ToxSox/aes17_filter/hardware/README.md

# AES17 filter board: files and how to order

The passive class-D measurement filter from [docs/design-review.md](../docs/design-review.md),
as a board. Everything here is generated from `design.py`; nothing was drawn by hand, so a
changed value or part is a changed line and a re-run.

| File | What it is |
|---|---|
| `design.py` | every part with value, footprint, LCSC number and note; every net |
| `make_pcb.py` | places and routes the board with KiCad 7's `pcbnew` module, fills the ground planes, runs the DRC; writes `aes17-filter.kicad_pcb` |
| `export.py` | writes `fab/`: the Gerber + drill zip, the JLCPCB bill of materials and placement file, a parts list with notes |
| `make_schematic.py` | draws `aes17-filter-schematic.svg/.png` (schemdraw) |
| `make_frontwall.py` | draws the front wall's drilling and the panel legend, `aes17-filter-frontwall.svg/.png` |
| `check_release.py` | checks that the board, the order files, the source hash and the DRC report belong together; exit code 0 = fit to order |
| `aes17-filter.kicad_pcb` | the board, for KiCad 7 or newer; there is no `.kicad_sch`, the schematic is the drawing |
| `fab/aes17-filter-gerbers.zip` | upload this to JLCPCB |
| `fab/aes17-filter-bom.csv` | upload this as the BOM (Comment, Designator, Footprint, LCSC Part #) |
| `fab/aes17-filter-cpl.csv` | upload this as the placement file (Designator, Mid X, Mid Y, Layer, Rotation) |
| `fab/aes17-filter-parts.csv` | the same parts with values and notes, for ordering anything elsewhere |
| `fab/aes17-filter-schematic.pdf`, `fab/aes17-filter-drc.txt` | the schematic and the DRC report of this release |
| `fab/RELEASE.txt` | title, revision, the source hash printed on the board, and the SHA-256 of every order file |

top side

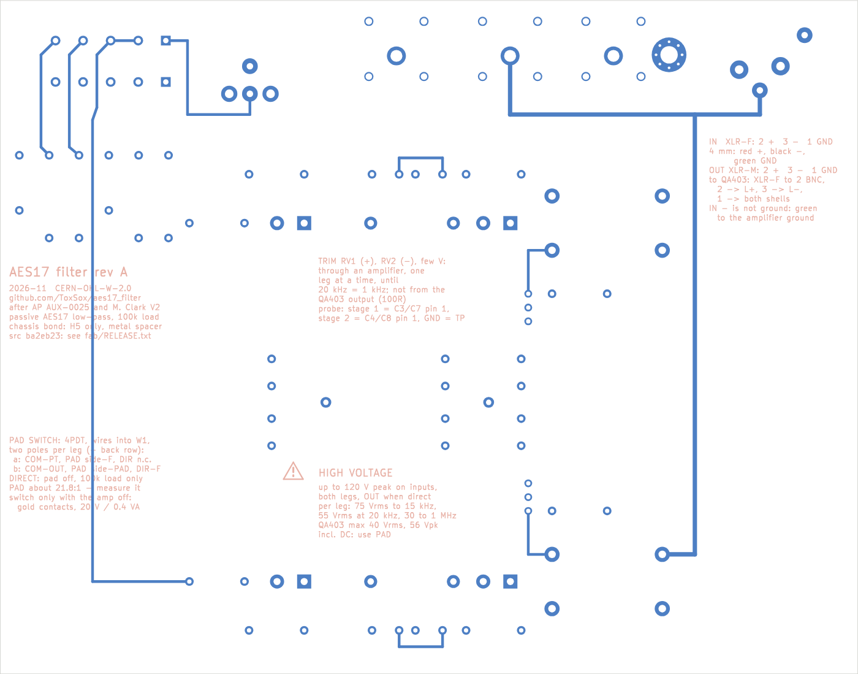
[picture p2: hardware/aes17-filter-bottom.png]
bottom side, seen from below: the crib sheet


## The board

158 × 124 mm, four layers, 1.6 mm, in a **Hammond 1444-862** aluminium chassis (203 × 152 × 51 mm,
flat 1 mm walls, closed by the 1434-86 bottom plate). **Every connector is on the front long
edge** and comes through the chassis' front long wall, so the filter hangs with that wall towards
the operator, as the AUX-0025's front panel does. From the left, seen from the front: the female
XLR input (pin 2 +, pin 3 −, pin 1 and shell ground), red and black 4 mm sockets at AP's
19.05 mm for a dual banana plug, the green common, the male XLR output (pin 2 +, pin 3 −), and
the pad toggle, mounted high in the wall straight above the switch. The QA403 is fed through a
self-made lead, XLR female to two BNC males. The first 24 mm behind the front edge are the
connector strip with the switch and the pad block at its right-hand end; the filter is the
100 mm band behind it, the two legs mirror images about its centre line. Layers 2 and 3 are
whole ground planes, broken only by the holes; every track is on layer 1 or 4. The board stands
on seven M3 spacers on the bottom plate (four on the centre line, H5 in the connector strip,
H6 and H7 in the back corners); the XLRs are screwed to the wall, the Cliff sockets held
by the board alone (they have no panel retention; the wall just has a clearance hole for the
Ø11 barrel). The DRC in KiCad 7 reports no errors and no unconnected nets at 0.8 mm clearance;
the warnings are silkscreen over pads and the footprints not being from a library table.

### Layout rules it follows

The board was gone over once more with the usual rules for audio layout. What they changed:

- **Whole ground planes.** Layers 2 and 3 carry nothing but ground. The earlier layout ran the
  two filter outputs on layer 3, which cut slots into the plane right under the output tracks
  on layer 4; those tracks lost their return path exactly where the analyzer's signal ran.
- **Clearance for the voltage.** Everything from the input up to OUT (in the direct position)
  carries the amplifier's voltage: laid out for 120 V peak (85 Vrms per leg, above the 75 Vrms rating). IPC-2221B asks 0.8 mm
  between bare pads at 101-300 V; the board had 0.3 mm and now keeps 0.8 mm everywhere. The
  male XLR's lands on pins 1 and 2 are 3.0 mm instead of Neutrik's 3.4 mm for the same reason.
- **The pad and the switch at the output connector.** The two pads now stand side by side right
  behind the switch, identical copies, so they share a temperature and their ratios track. The
  4PDT toggle sits in the wall straight above W1, ten solder holes, and its wires drop about
  15 mm into them; before, they ran 75 mm through the box to a header in the middle of the
  board. W1's holes run in the order the nets leave the pad block (OUT, F, F, PT, PAD), the +
  leg's row on top and the − leg's on the bottom, so no track crosses another; the − leg's tracks
  come down between the + row's holes, 5.08 mm apart for exactly that.
- **Long runs only at low impedance.** The negative leg ends at the back of the board, so one
  track has to come forward. It is now the filter output F_N, behind 24.9 Ω, the lowest
  impedance in the chain, and it runs alone through empty board. Before, the output pair came
  back to the middle of the board, and in the pad position OUT sits behind 950 Ω, where 1 pF of
  stray capacitance from the input side is already −50 dB at 500 kHz.
- **Pairs kept together.** IN+ and IN− run on top of each other (layer 1 over layer 4) from the
  connectors to where the legs part; OUT+ and OUT− run side by side, 1 mm apart, from W1 to the
  XLR. Before, the negative input went round the board's left edge and the two outputs ran 10 mm
  apart.
- **More distance between the stages.** The second coil of each leg is 38 mm from the first
  instead of 32 mm. Coupling between two drum cores falls with the cube of the distance, so
  L1 → L2, the one path that bypasses the filter, is about 4.5 dB weaker.
- **One chassis bond, where the cables come in.** H5 is a plated hole on ground in the
  connector strip, next to the input XLR: with a metal spacer it ties the ground plane to the
  bottom plate and so to the chassis, and cable shield currents go to the chassis there instead
  of crossing the filter. The other six holes are plain.

What stayed as it was, because it was right: the two legs mirror images, so each sees the same
parasitics; the shunt capacitors' grounds meeting in the middle of the board, so the
differential residue current takes a short path between the legs; polypropylene capacitors and
metal-film resistors throughout; the hot 3 W input resistors well away from the polypropylene
capacitors (FKP2 is rated to 100 °C).

### Silkscreen

Top: every part with its name and value in the notation that survives a lost dot (R1 1k 3W,
R7 24R9, C3 4n7, L1 1mH), the pad block with a legend under each pad, each leg's signal flow
along its outer edge (input network, stage 1, stage 2, pad), a high-voltage warning beside the
inputs, W1's ten holes labelled for the toggle wires (+OUT, +F, +F, +PT, +PAD and the same with −), and the title
"AES17 filter rev A" with date, licence and source location (the CERN-OHL-W asks for the source
location on the product where practicable). Bottom, readable from below: a crib sheet with the
connector pin-outs and the QA403 lead, the switch wiring, the trim procedure and
the voltage limits. Both sides carry "src" and the source hash, the first seven digits of the
SHA-256 of `design.py` and `make_pcb.py`, the same as in `fab/RELEASE.txt`. Two ground loops,
TP1 and TP2, sit between the stages for a scope probe's ground spring. Title, revision and date
are three constants at the top of `design.py`.

## Ordering at JLCPCB

0. **Check the release.** `python3 hardware/check_release.py` must end with "fit to order".
   Order from a commit, not from a working copy, and keep its source hash (in `fab/RELEASE.txt`
   and printed on both sides of the board, "src ...") with the order: a board in the hand is
   then matched to its files without guessing.
1. **PCB.** Upload `fab/aes17-filter-gerbers.zip`. Four layers, 1.6 mm, any colour, 1 oz copper,
   HASL or ENIG as you like, five pieces (the minimum). The stack-up JLCPCB offers for four
   layers (JLC04161H-7628 or similar) is fine; nothing here depends on impedance.
2. **Assembly.** Tick assembly, **five boards** (all of them: two for this bench, two for a
   colleague's, one spare; JLCPCB's minimum is two), top side only, Economic. Upload
   `fab/aes17-filter-bom.csv` and `fab/aes17-filter-cpl.csv`. All parts are through-hole;
   JLCPCB hand-solders those ($3.58 per order plus $0.0164 per joint, one extra day).
3. **Parts review.** In the parts page every line with an LCSC number resolves on its own,
   because the files hold only parts JLCPCB had in stock. **Left out, to be bought locally and
   soldered by hand:** the coils L1-L4 (Würth 7687480102, Digi-Key; at JLCPCB only the
   7447480102, C1331132, on pre-order), the 412 Ω R4/R14, the Cliff sockets J1-J3 and the film
   capacitors C1-C10. The shielded
   WE-TIS 7447471102, C1331105, fits the same footprint; it was the coil of the first draw of
   rev A and is now only the comparison for the linearity test (JLCPCB lists it as ±20 %, which
   the trimmer cannot always reach). The 412 Ω 0.6 W had three pieces in stock at JLCPCB
   (C1235858) on 2 November 2026; any 412 Ω 1 % 0.6 W in a 0207 body does. The
   BOM file is plain ASCII on purpose: JLCPCB's import reads "Würth" as "W眉rth". The ten WIMA film capacitors (C1-C10) are **not in the BOM and the placement file**: JLCPCB has them only on pre-order (19-21 working days, quoted on 3 November 2026), so they are bought locally and soldered by hand. The Cliff sockets would be **pre-order** too: JLCPCB
   buys them after payment, quotes the final price within 48 hours, and they take nine to
   twenty business days to arrive; connectors carry a $20 inspection fee per type, so the three
   Cliff colours cost $60 in inspection alone. So they are **left out of the assembly** (they
   are not in the files), bought at Digi-Key (6.80 € each against $11-12 pre-order) and solder the three per board yourself - one
   pin and four pegs each.
4. **Every line has an LCSC number.** The pad's upper arms (R8, R9, R18, R19) are TE YR1B10KCC,
   10.0 kΩ 0.1 % 15 ppm, C1364313 (2 397 in stock on 2 November 2026), the same family as the
   1.00 kΩ lower arm; a 0207 body on the 15.24 mm pitch. R6/R16 are the Vishay MRS25 3.40 kΩ
   0.6 W, C1366835 (125 in stock).
5. **W1 is not a part.** It is ten plated holes for the toggle's wires and is not in the BOM or
   the placement file; the 4PDT toggle is bought separately (RS, Mouser) and wired by hand.
6. After the order: the five boards arrive assembled. Nothing else is needed from JLCPCB.

### What JLCPCB's BOM tool quoted on 1 November 2026

For an assembly of five boards (quantities include JLCPCB's attrition allowance), in euros:

| Line | Qty | Total | Per piece | Status |
|---|---|---|---|---|
| TE 5227161-7 BNC (C591726) | 20 | 99.63 | 4.98 | in stock; no longer on the board - the XLR output replaced the BNCs |
| Cliff FCR7350R / B / G (C6041087 / C6555263 / C6041085) | 5 each | 58.13 / 58.13 / 50.32 | 11.6 / 11.6 / 10.1 | **shortage: pre-order**, plus the connector inspection fee per type |
| WIMA 220 pF 630 V ±2.5 % (C5742108) | 30 | 7.19 | 0.24 | shortage: pre-order, 19 working days; now soldered by hand instead |
| WIMA 4.7 nF 250 V (C20412818) | 25 | 10.70 | 0.43 | shortage: pre-order, 21 working days; now soldered by hand instead |
| Bourns 3296W-1-501LF (C69564) | 10 | 6.75 | 0.67 | in stock |
| TE YR1B1K0CC 0.1 % (C1364308) | 10 | 3.57 | 0.36 | in stock |
| UNI-ROYAL 1 kΩ 3 W (C58750) | 21 | 1.04 | 0.05 | in stock |
| UNI-ROYAL 10 kΩ 1 W (C58714) | 21 | 0.51 | 0.02 | in stock; replaced by TE YR1B10KCC 0.1 % (C1364313, about 0.50 € each) |
| 75 Ω 1 W (C160685) | 11 | 0.47 | 0.04 | in stock |
| 14 k, 412, 3.4 k, 24.9 (C127223, C3558411, C3517441, C3542579) | 11-15 each | 0.15 / 0.06 / 0.17 / 0.36 | 0.01-0.02 | in stock; the 412 and 3.4 k are now 0.6 W Vishay MRS25 (C1235858, C1366835), not yet quoted |
| Würth 7447471102 coils | 20 | about 58 | 2.9 | "Vorbestellen" → global sourcing; replaced by the unshielded 7447480102 (C1331132, 2.14 €) |

About 356 € of parts for five assembled boards, 71 € per board, of which the three Cliff sockets
are 33 € and the four BNCs 20 € (the BNCs have since left the board). The Cliff sockets are the line to take out of the assembly:
pre-order at 11 € each plus the inspection fee, against 6.80 € at Digi-Key for a part with one
pin and four pegs to solder. That quote still holds the BNCs, the Cliff sockets, the film
capacitors and the coils, none of which is in the JLCPCB files any more; what JLCPCB fits now is
the resistors, the trimmers and the two XLRs, so the parts bill it shows at ordering is well
below it. The stock of all ten lines covered five boards on 3 November 2026; the tightest were
C58750 (1 kΩ 3 W, 153 for 20) and C1366835 (3.40 kΩ, 125 for 10).

## Shopping list, bought locally (five boards)

JLCPCB fits the 22 parts per board it had in stock. Everything else is bought locally; the
quantities are for all five boards and include what pairing the legs needs (see "Building the
boards", step 1). Pair from **one pool for all five**: any matched pair can go on any board.
**Why 24 of a ±5 % part for 20 places:** ten pairs within 1 % are wanted; the chance of finding
them is 21 % from 20 parts, 93 % from 22 and 100 % from 24 if the values spread evenly over the
tolerance, and 42 / 98 / 100 % for a typical reel, whose spread is narrower (simulated,
tolerance = 3σ). Two more cover a bent lead and give the winding-sense test its sender coil.
For a single board it would be 8 for 4 places (98 %), for two boards 12 for 8: the bigger the
pool, the smaller the surplus per board.

**On the board, soldered by hand:**

| Buy | Fitted | Part | Pairing | Where |
|---|---|---|---|---|
| 26 | 20 | **Würth 7687480102**, 1 mH ±5 %, unshielded drum core (L1-L4) | ten pairs, L1/L3 and L2/L4 per board, from 24 | Digi-Key |
| 26 | 20 | **WIMA FKP2F014701I00JA00**, 4.7 nF 250 V ±5 % (C3, C4, C7, C8) | ten pairs, C3/C7 and C4/C8 per board, from 24 | Digi-Key |
| 33 | 30 | **WIMA FKP2J002201D00ESSD**, 220 pF 630 V **±1 %** (C1, C2, C5, C6, C9, C10) | two ±1 % parts differ by 2 % at most, which is what the simulation counts as paired; measure and sort anyway: the closest two as C1/C5, then C2 + C9 against C6 + C10 | Bürklin 42D8516 |
| (40) | (30) | or the ±2.5 % FKP2J002201D00HSSD, if the ±1 % is not to be had | then pairing matters: 40 to choose from | Digi-Key, Bürklin |
| 12 | 10 | **412 Ω 1 % 0.6 W**, Vishay MRS25000C4120FCT00 or any 0207 body (R4, R14) | none needed | Digi-Key, Mouser, Bürklin |
| 5 each | 5 each | **Cliff FCR7350R, FCR7350B, FCR7350G**, red, black, green (J1-J3) | - | Digi-Key, Farnell |

**For pairing and the verification tests, not on the board** (one set does all five boards, if
one person pairs, trims and tests them; that is also how all five come out alike):

| Buy | Part | For |
|---|---|---|
| 1 each | 100 Ω, 6.8 kΩ, 47 kΩ, 1 %, 0.25 W | the series resistor when pairing with the QA403: coils, 4.7 nF, 220 pF |
| 2 + 1 | 10 kΩ and 1 kΩ, 1 %, **3 W or more**, metal film (the UNI-ROYAL MFR03S on the board, or a Vishay PR03) | test 4's reference divider, 2 × 10 k over 1 k as the pad: at 75 Vrms it runs at about 4 % of its rating, so it adds no self-heating distortion of its own |
| 1 | 1 Ω, 1 % | test 5's current shunt in the green lead |
| 4, optional | Würth WE-TIS 7447471102, shielded | test 4's comparison, one board's worth (availability outside JLCPCB not checked) |

Plus the box, the toggle and the leads in the next table.

## What is not on the board

| Qty for five boards | Part | Where |
|---|---|---|
| 20 | screws for the XLR flanges: M3 × 8 and nuts if the flange holes are through-holes, else 2.9 mm self-tapping (Neutrik's drawing of the NC3FAAH2 / NC3MAAH decides; not checked) | any |
| 2 | a cable from the amplifier's terminals to a male XLR plug (pin 2 +, pin 3 −), or dual banana leads - the same cable then feeds an AUX-0025; one per bench | self-made |
| 2 | an XLR-female-to-two-BNC-male lead to the QA403: pin 2 to L+ centre, pin 3 to L− centre, pin 1 to both BNC shells; about 30 cm, both legs equal; one per bench | self-made (Neutrik NC3FXX, two BNC plugs, two pieces of RG58 or RG174) |
| 5 | **4PDT** toggle, ON-ON, non-shorting, **gold contacts**, panel mount, 1/4 in bushing, solder lugs; best with a locking lever | APEM 5666CDB or another 4PDT with gold contacts; the switch carries microamperes at 100 kΩ, a dry circuit, so standard silver contacts (a plain Knitter MTA 206, for one) are not suitable. Gold contacts are rated to switch only 0.4 VA at 20 V: they carry the full voltage closed, but are switched with the amplifier off |
| 5 | insulating sheet, 0.25 mm polyester or fish paper, cut to the bottom plate around the spacers | any |
| 5 | Hammond 1444-862 chassis and 1434-86 bottom plate | Digi-Key, Mouser, Reichelt; about 20 € and 11 € |
| 35 | M3 spacers, 10 mm, and M3 screws, for the board on the bottom plate (seven per board); the one under H5 metal, with a star washer on the bottom plate | any |
| | wire for the toggle: ten pieces per board of about 25 mm, 0.25 mm² stranded, into W1's holes | |

## Building the boards

1. Check the assembled board against `fab/aes17-filter-parts.csv`.
   Then solder what JLCPCB leaves out, per board: the 412 Ω 0.6 W in R4 and R14; the coils,
   L1/L2 (+ leg) and L3/L4 (− leg), all four with the same winding sense (see below); 220 pF in C1, C2, C9 (+) and C5, C6, C10 (−),
   4.7 nF in C3, C4 (+) and C7, C8 (−); and the Cliff sockets, red J1, black J2, green J3. Before
   soldering, **measure coils and capacitors and give the two legs the closest pairs** (L1/L3,
   L2/L4, C1/C5, C2+C9 / C6+C10, C3/C7, C4/C8); the polypropylene parts have no polarity. For
   the frequency response the trimmer takes care of the spread, but not for the legs' phase:
   pairing **both** coils and capacitors to 1 % moves the common mode in the difference from
   −31 to −45 dB at 20 kHz and from −14 to −29 dB at 100 kHz (simulation, 95 % of boards);
   pairing only one of the two gains 2-4 dB, because the other still sets the phase.

   **Pairing without an LCR meter**, with the QA403: its output through a series resistor
   into the part, the part's other end to ground; the left input across the part, the right
   input on the output. Sweep once to find where the left reads 3 dB below the right, then
   read every part of that value at that frequency: 1 % in value is about 0.04 dB there. The
   resistor sets the frequency: 6.8 kΩ for the 4.7 nF (about 5 kHz), 47 kΩ for the 220 pF
   (about 10 kHz with the lead's capacitance), 100 Ω for the 1 mH coils (about 16 kHz). Keep
   the leads and the part's position the same for every part of one value; only the
   differences count.

   **Winding sense of the coils.** For the filter either way round works, but an unshielded
   drum core picks up stray magnetic fields (a mains transformer, a load bank), and the
   aluminium box does not screen 50 Hz. A field that reaches both legs alike then appears as
   common mode, which the QA403 rejects, only if L1 and L3 (and L2 and L4) are the same way
   round; Würth does not mark the start of the winding. To find it with the QA403 before
   soldering: QA403 output, 1 kHz at about 1 V, into one coil (the "sender") through 100 Ω;
   stand each other coil on top of it, axis on axis and always leads up, its leads to the left
   input, and read the phase against the output: about +90° or −90° (the induced voltage leads
   the current). Mark the lead that gives +90° on the left input's centre pin and put it in the
   square pad on all four. Then test the sender itself the same way, with a marked coil as
   the sender.
2. Drill the front wall after `aes17-filter-frontwall.png`; the hole table is at the end of this
   file. Easiest and safest: drill the seven spacer holes in the bottom plate, stand the board on
   its spacers, put the chassis over it, and mark the connector centres through from inside.
3. Fit the board on the bottom plate, put the chassis over it, screw the XLR flanges to the
   wall, fit the toggle.
4. Wire the 4PDT toggle into W1, straight below it, by the silkscreen labels: two poles per
   leg, the + leg to the back row, the − leg to the front row. Decide which lever position is
   PAD and call the throw lugs on that side "PAD side", the others "DIR side"; then per leg
   - pole a: common → PT, PAD side → F, DIR side not connected
   - pole b: common → OUT, PAD side → PAD, DIR side → the other F
   Check with an ohmmeter between the output XLR's pin 2 (then pin 3) and pin 1, inputs open:
   about 1.0 kΩ in PAD (the pad's 1 kΩ leg), open in DIRECT (the pad is off). And from the red
   (then black) input to the green: about 21 kΩ in PAD, open in DIRECT. Mark the positions on the
   front.
5. Lay the insulating sheet on the bottom plate before the board goes in; use a metal spacer
   under H5 and plastic or metal under the rest (only H5 is plated). Set the trimmers (step 6)
   with a few volts from the amplifier: the trim does not depend on the level, and the box is
   open while you turn them.
6. Work through the [verification plan](../docs/design-review.md#verification-what-makes-it-a-reference):
   trim both legs through an amplifier until 20 kHz equals 1 kHz, the pad ratio over frequency
   into the measurement software's probe settings, then the ferrite, ground, heat and stop-band tests before the
   filter is used as a reference. Connect the green socket to the amplifier's ground in use.

## Regenerating

```
python3 hardware/make_pcb.py        # board + DRC report (needs KiCad 7 with pcbnew for Python)
python3 hardware/make_schematic.py  # schematic, also fab/…-schematic.pdf (pip install schemdraw)
python3 hardware/export.py          # fab/ and fab/RELEASE.txt (needs kicad-cli; after the schematic)
python3 hardware/make_frontwall.py  # front wall drilling (matplotlib)
python3 hardware/check_release.py   # do the files belong together?
```

Run `make_schematic.py` before `export.py`: the schematic PDF is one of the files the release
manifest hashes.

## Front wall holes

See `aes17-filter-frontwall.png`; the table below is printed by `make_frontwall.py`. In blue the
drawing also carries the legend for the panel: the rating per leg at the inputs, "GND to the
amplifier ground", the switch positions and DIRECT's 40 Vrms limit. The wall is
the front long wall of the Hammond 1444-862, seen from outside, x from its left end, y from its
bottom edge (which rests on the 1434-86 bottom plate).

| Hole | Ø mm | x | y |
|---|---|---|---|
| XLR IN (female), Neutrik NC3FAAH2 | 22.5 | 40.6 | 24.1 |
| its two M3 screws, upper left and lower right | 3.2 | 30.7 / 50.5 | 34.0 / 14.2 |
| 4 mm IN + (red) | 11.5 | 67.6 | 17.9 |
| 4 mm IN − (black), 19.05 mm from the red one | 11.5 | 86.6 | 17.9 |
| 4 mm GND (green) | 11.5 | 107.6 | 17.9 |
| XLR OUT (male), Neutrik NC3MAAH | 22.5 | 134.6 | 24.1 |
| its two M3 screws, upper left and lower right | 3.2 | 124.7 / 144.5 | 34.0 / 14.2 |
| pad toggle, 1/4 in bushing | 6.4 | 158.6 | 35.6 |

The heights assume the board on **10 mm M3 spacers** on the bottom plate, so its top surface is
11.6 mm above the wall's bottom edge; the Cliff socket axis is 6.3 mm above the board, the XLR
axis 12.5 mm, the toggle's 24 mm (so that the 4PDT's body, about 13 × 17 mm and 20 mm deep with its lugs, clears the board). **The XLR axis height is read off Neutrik's front view, not a dimensioned value:
fit the board on its spacers, hold the undrilled wall against the connector fronts and mark
through before drilling.** The board's front edge sits 3.3 mm behind the wall's inner face, so
the XLR flanges and the shoulders of the 4 mm sockets lie against the wall. Cliff does not
specify a panel hole for the S16N-PC; Ø11.5 clears its Ø11.0 barrel. Neutrik asks for a hole of
at least Ø22 and two Ø3.2 screw holes 19.8 mm apart on the diagonal.
