ToxSox/aes17_filter/hardware/fab/aes17-filter-schematic.pdf

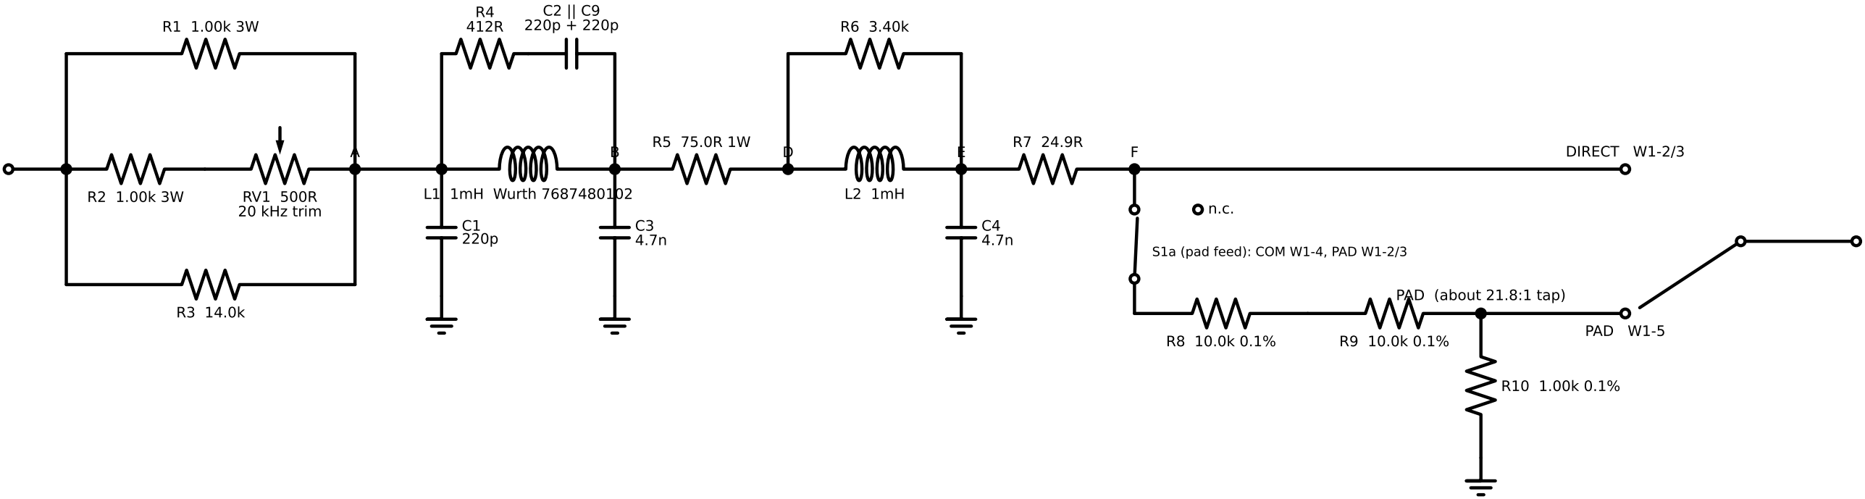
[picture p4: figure]
20 kHz trim; 1mH Wurth 7687480102; S1a (pad feed): COM W1-4, PAD W1-2/3; PAD (about 21.8:1 tap); DIRECT W1-2/3; PAD W1-5

Negative leg, IN - (J4 XLR pin 3 / J2 black) to OUT - (J5 XLR pin 3): identical; R11-R20, RV2, C5-C10, L3, L4; its switch is poles c and d of S1: OUT W1-6, F W1-7/8, PT W1-9, PAD W1-10. XLR pin 1 and shell, J3 (green 4 mm), the ground plane and the box: GND = the QA403's Audio Common. Connectors as on the AP AUX-0025; the QA403 takes an XLR-to-two-BNC lead. S1: 4PDT ON-ON toggle in the front wall, non-shorting, gold contacts (APEM 5666CDB or similar), its wires soldered into W1; drawn in the PAD position.
In DIRECT the pad is off the output: the filter sees the analyzer alone, as the AUX-0025 does (about 1.006:1). In PAD the analyzer sees about 1/22 of the amplifier (measure it);
DIRECT is the full voltage, DC included: a single-supply bridged amplifier idles at half its supply on both legs, which adds to the peak the QA403 sees.
All values from design.py, sha256 768abdc.

IN + J4 XLR pin 2 and J1 (red 4 mm) in parallel

OUT + S1b COM W1-1 to J5 XLR pin 2
