ToxSox/aes17_filter/hardware/aes17-filter-frontwall.png

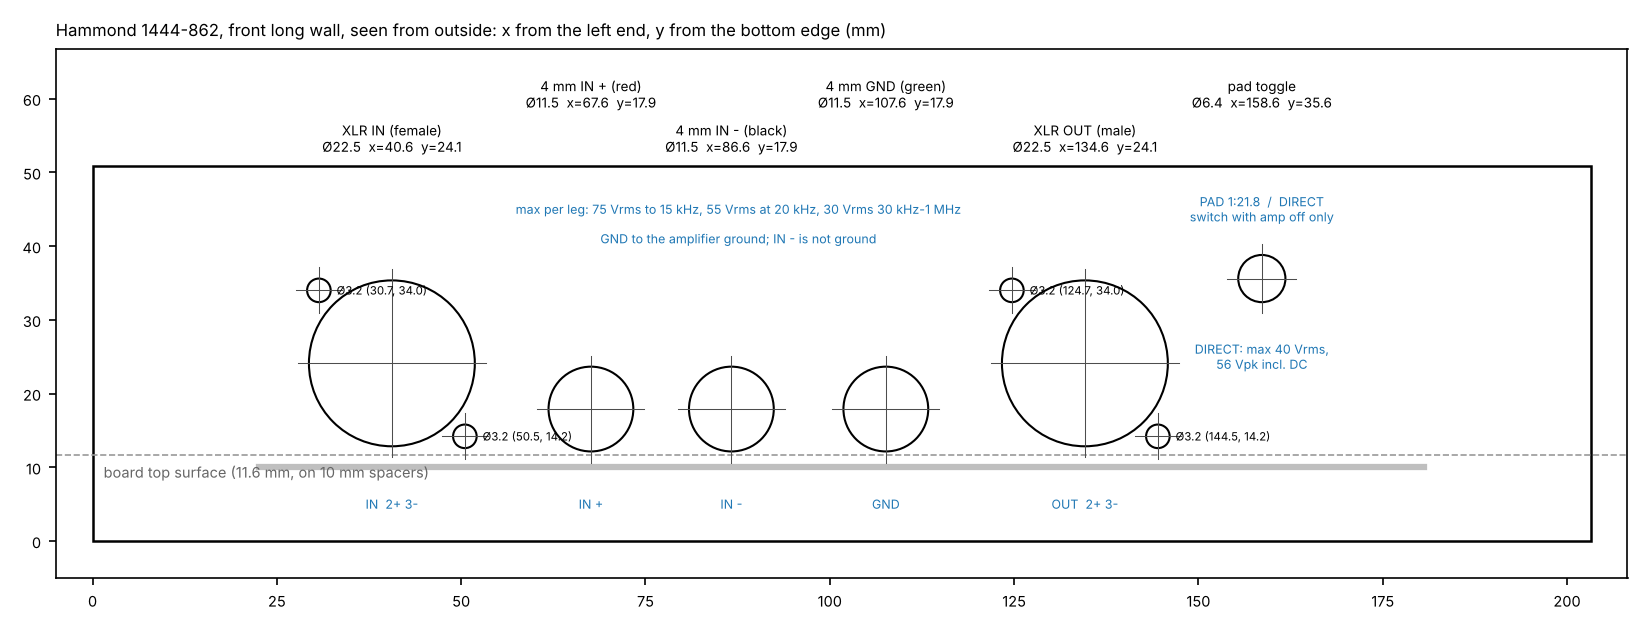
hardware/aes17-filter-frontwall.png
