ToxSox/aes17_filter/hardware/aes17-filter-schematic.png

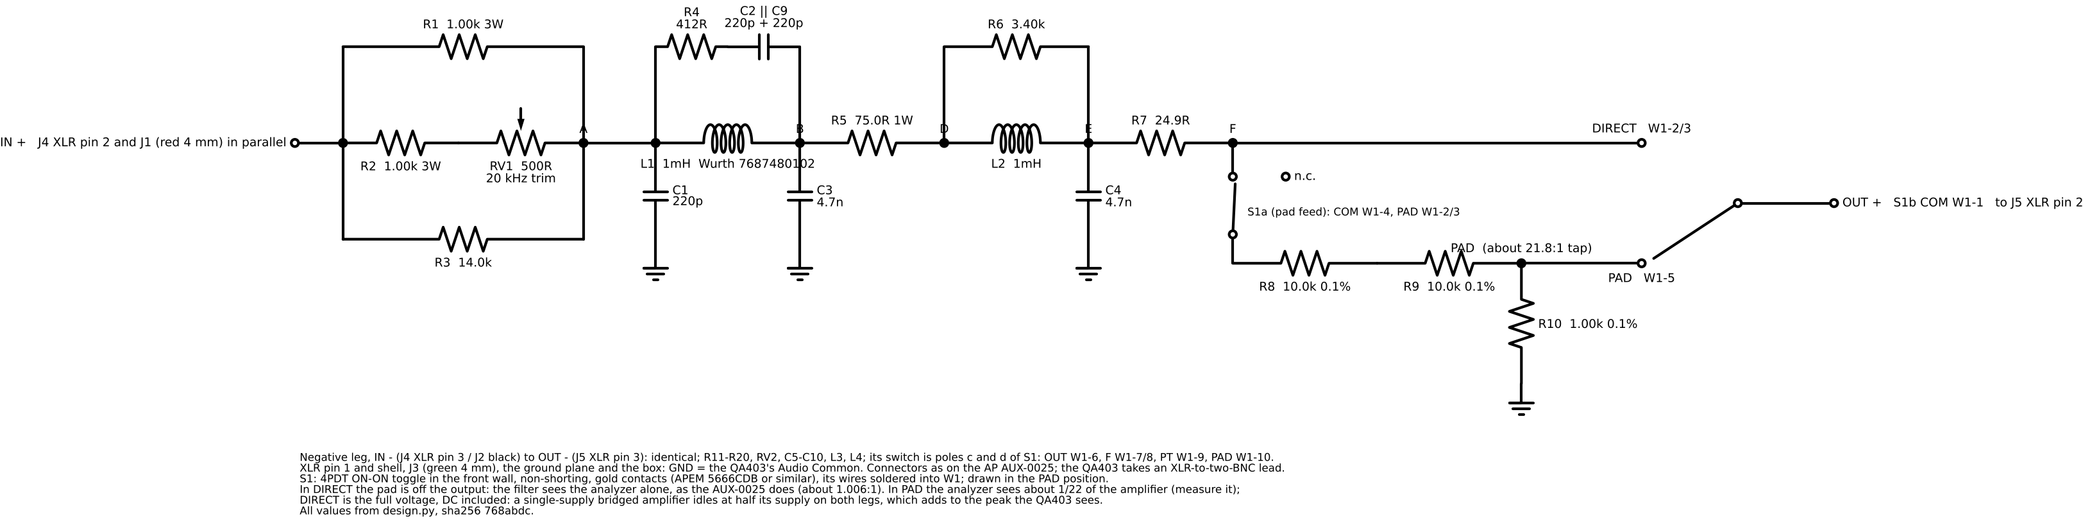
hardware/aes17-filter-schematic.png
