ToxSox/aes17_filter/docs/shopping-2026-11-03.md

# Shopping list for the five boards, as ordered from 3 November 2026

This build differs from hardware/README.md in two ways:

- **No enclosures for now.** The boards stand on their spacers; the Hammond 1444-862 and 1434-86
  can be bought later, per board.
- **Only two 4PDT toggles.** Two boards get a toggle. The colleague's two boards (straight into an
  AP analyzer, no pad) and the spare get two wire bridges in W1 instead, hole 1 to 2 and hole 6
  to 7 (OUT to F in each leg), and run fixed on DIRECT. PT and PAD stay open.

Prices were read on 3 November 2026. RS prices are net (add 19 % VAT), Reichelt's are gross. The
TME figure is what its cart showed, shipping included.

## Total

| Shop | Gross | Status |
|---|---|---|
| JLCPCB, five assembled boards | 169.71 € | ordered |
| RS | 121.57 € | ordered |
| TME | 88.77 € | ordered |
| Reichelt, with shipping | 34.93 € | ordered |
| Not priced, see below (estimate) | 5-10 € | open |
| **Total** | **about 420-425 €, 85 € per board** | |

Still to pay: about 5-10 €, the hardware store items.

## 1. JLCPCB: ordered

| Line | Amount |
|---|---|
| Merchandise (PCB and assembly) | 109.58 € |
| Shipping | 32.13 € |
| Customs duties and taxes | 30.48 € |
| Duty and tax disbursement fee | 7.38 € |
| Discount | −13.86 € |
| PayPal fee | 2.52 € |
| **Order total** | **169.71 €** |

These lines add up to 168.23 €, 1.48 € less than the order total; check against the invoice.
The placement file of this order is commit 72c08ab on the branch release/rev-a.

## 2. RS Components (de.rs-online.com): ordered, free shipping from 100 €

| Qty | Part | RS no. | Unit net | Total net | Stock |
|---|---|---|---|---|---|
| 2 | APEM 5666CDB, 4PDT ON-ON, gold contacts, solder lugs | 692-5217 | 22.06 € | 44.12 € | 84 |
| 40 | Würth 7687480102, 1 mH ±5 %, L1-L4 (20 fitted) | 259-1050 | 0.88 € (40+) | 35.20 € | 53 |
| 10 (one pack) | Vishay PR03000201002JAC00, 10 kΩ 5 % 3 W, test 4 | 683-5900 | 0.346 € | 3.46 € | 850 |
| 10 (one pack) | Vishay PR03000201001JAC00, 1 kΩ 5 % 3 W, test 4 | 683-5887 | 0.346 € | 3.46 € | 110 |
| 2 | Neutrik NC3FXX, XLR-to-BNC leads to the QA403 | 166-254 | 4.19 € | 8.38 € | 147 |
| 2 | Neutrik NC3MXX, amplifier-to-XLR cables | 166-260 | 3.77 € | 7.54 € | 277 |
| | | | | **102.16 € net, 121.57 € gross** | |

The order is only just over the free-shipping limit, on purpose: 40 coils cost 5 € more than 26
and the XLR plugs would otherwise come from Reichelt. Check in the cart that shipping shows 0 €;
one line removed drops it below 100 €, and RS then charges 8.95 € shipping.

The README asks for 1 % in test 4's divider and names the PR03, which is 5 %. Test 4 needs a
resistor that does not heat up; the ratio is measured anyway.

## 3. TME (tme.eu): ordered

| Qty | Part | Total |
|---|---|---|
| 5 | Cliff FCR7350R, red (J1) | |
| 5 | Cliff FCR7350B, black (J2) | |
| 5 | Cliff FCR7350G, green (J3) | |
| | | **88.77 € gross with shipping** |

Digi-Key would be 122.51 € gross for the same fifteen. Green was the tight line at TME: 50 in
stock.

## 4. Reichelt (reichelt.de): ordered, 5.95 € shipping (DHL, up to 10 kg)

| Qty | Part | Reichelt no. | Unit gross | Total gross |
|---|---|---|---|---|
| 40 | WIMA FKP2J002201D00HSSD, 220 pF 630 V ±2.5 % (C1, C2, C5, C6, C9, C10) | FKP2-630 220P | 0.25 € | 10.00 € |
| 26 | WIMA FKP2J014701I00HSSD, 4.7 nF 630 V ±2.5 % (C3, C4, C7, C8) | FKP2-630 4,7N | 0.32 € | 8.32 € |
| 12 | 412 Ω 1 % 0.6 W metal film, 0207 (R4, R14) | METALL 412 | 0.035 € (10+) | 0.42 € |
| 1 | 100 Ω 1 %, pairing | METALL 100 | 0.09 € | 0.09 € |
| 1 | 6.8 kΩ 1 %, pairing | METALL 6,80K | 0.07 € | 0.07 € |
| 1 | 47 kΩ 1 %, pairing | METALL 47,0K | 0.07 € | 0.07 € |
| 1 | 1 Ω 1 %, test 5 | METALL 1,00 | 0.08 € | 0.08 € |
| 35 | M3 hex spacer, metal, 10 mm, female-female, the board's feet | DI 10MM | 0.175 € | 6.13 € |
| 2 | BNC-BNC lead, RG58, 2 m; cut in half, gives the four BNC legs without a crimp tool | KBK 102 2M | 1.90 € | 3.80 € |
| | | | | **28.98 € + 5.95 € shipping = 34.93 €** |

All lines were in stock, 1-2 working days.

**Two deviations from hardware/README.md:**

- The 220 pF is the ±2.5 % part, 40 pieces, which the README allows if the ±1 % is not to be had.
  The ±1 % is stocked only at Bürklin (42D8516, 33 pieces 58.74 € net). Digi-Key's ±2.5 % has a
  24 000-piece minimum.
- The 4.7 nF is the 630 V ±2.5 % FKP2J014701I00HSSD instead of the 250 V ±5 % FKP2F014701I00JA00.
  Same body (7.2 × 6.5 × 8.0 mm, 5 mm pitch), half the tolerance, so pairing is easier. The
  250 V ±5 % equivalent is FKP2-250 4,7N at 0.24 €.

The toggle wire and the amplifier cable are from stock; the toggle wires can see 75 Vrms (106 V peak), so the wire must
be rated above that. The wire bridges on the three boards without a toggle are cut resistor leads.

## Not priced: from a hardware store

- 70 M3 × 6 screws, steel, 35 now and 35 for the bottom plates of a later box. Reichelt's steel M3
  screws start at 10 mm, and in a box two of those collide in the 10 mm spacer: M3 × 6 from both
  sides leaves 0.9 mm between them. Its nylon SP M3X6 (8.25 €, 100 pieces) would do except at H5,
  which needs metal for the ground contact.
- two small aluminium brackets for the toggles, with a 6.5 mm hole

## Later, if the boards get their box

| Per box | Part | Digi-Key no. | Unit net at 5 |
|---|---|---|---|
| 1 | Hammond 1444-862 chassis | HM1495-ND | 16.83 € |
| 1 | Hammond 1434-86 bottom plate | HM2710-ND | 9.14 € |

Below five pieces they are 19.99 € and 10.87 €. Digi-Key had 8 and 5 in stock, Mouser 23 and 6.
Each box then also takes four M3 × 8 or M3 × 10 screws and nuts for the XLR flanges, a star washer
for H5, and an insulating sheet.
