ToxSox/aes17_filter/hardware/aes17-filter.kicad_pcb

## KiCad design hardware/aes17-filter.kicad_pcb (2026-11-03)

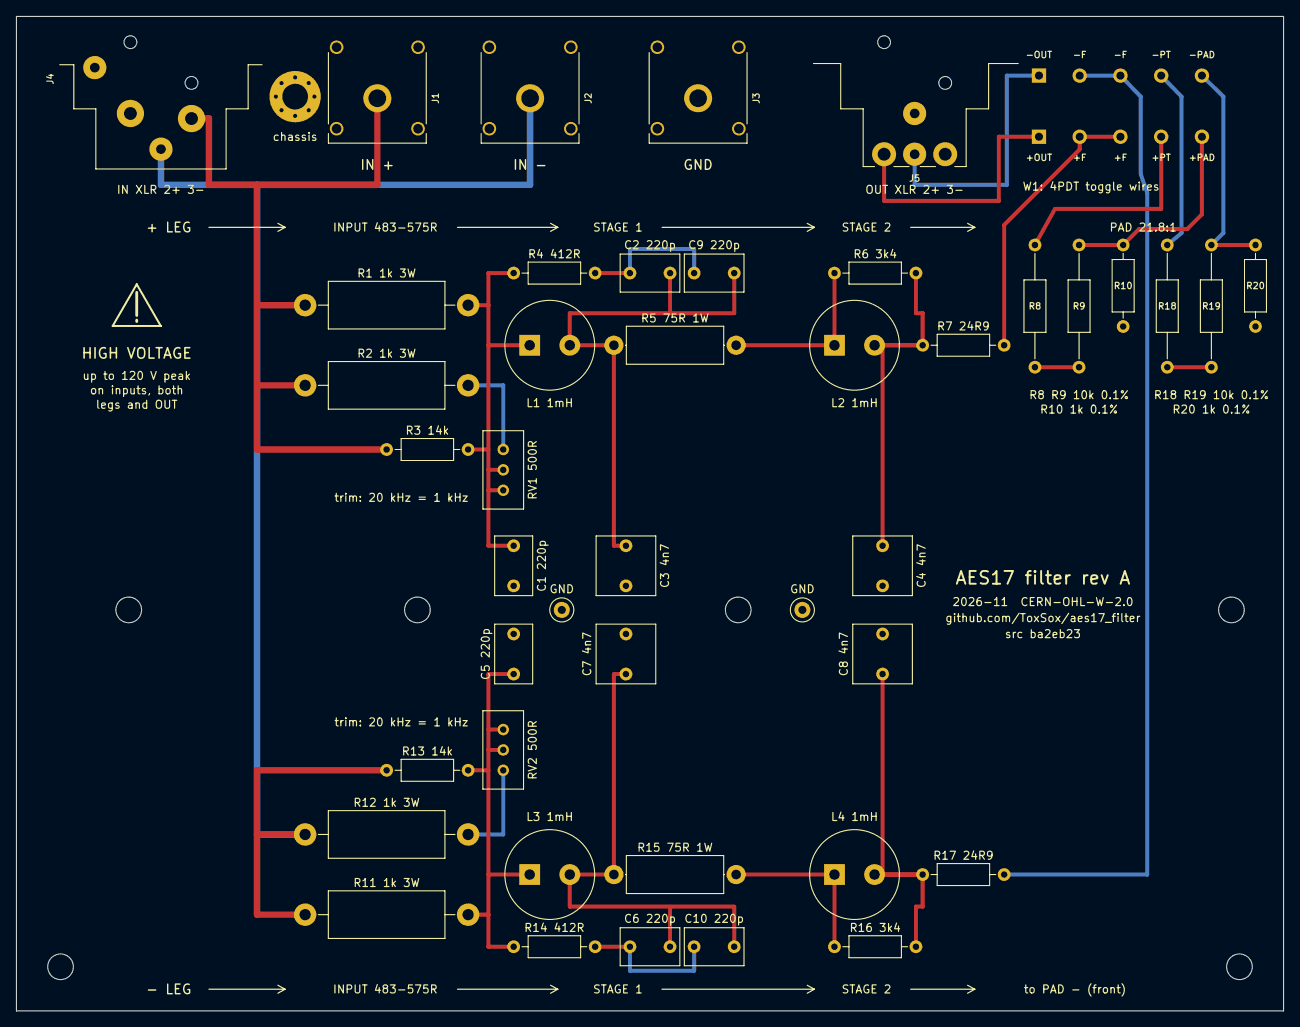
[picture p7: board aes17-filter.kicad_pcb from above]

Board: 4 copper layers, 158.0 x 124.0 mm, 51 parts (0 on the bottom side), 25 nets.

Parts:
C1, C2, C5, C6, C9, C10: 220p; C_Rect_L7.2mm_W4.5mm_P5.00mm_FKS2_FKP2_MKS2_MKP2
C3, C4, C7, C8: 4.7n; C_Rect_L7.2mm_W7.2mm_P5.00mm_FKS2_FKP2_MKS2_MKP2
H1, H2, H3, H4, H6, H7: M3; MountingHole_3.2mm_M3
H5: M3 GND; MountingHole_3.2mm_M3_Pad_Via
J1: IN +; Banana_Cliff_FCR7350R_S16N-PC_Horizontal
J2: IN -; Banana_Cliff_FCR7350B_S16N-PC_Horizontal
J3: GND; Banana_Cliff_FCR7350G_S16N-PC_Horizontal
J4: IN XLR; Jack_XLR_Neutrik_NC3FAAH2_Horizontal
J5: OUT XLR; Jack_XLR_Neutrik_NC3MAAH_Horizontal
L1, L2, L3, L4: 1mH; L_Radial_D11.5mm_P5.00mm
R1, R2, R11, R12: 1.00k 3W; R_Axial_DIN0614_L14.3mm_D5.7mm_P20.32mm_Horizontal
R3, R13: 14.0k; R_Axial_DIN0207_L6.3mm_D2.5mm_P10.16mm_Horizontal
R4, R14: 412R; R_Axial_DIN0207_L6.3mm_D2.5mm_P10.16mm_Horizontal
R5, R15: 75.0R 1W; R_Axial_DIN0414_L11.9mm_D4.5mm_P15.24mm_Horizontal
R6, R16: 3.40k; R_Axial_DIN0207_L6.3mm_D2.5mm_P10.16mm_Horizontal
R7, R17: 24.9R; R_Axial_DIN0207_L6.3mm_D2.5mm_P10.16mm_Horizontal
R8, R9, R18, R19: 10.0k 0.1%; R_Axial_DIN0207_L6.3mm_D2.5mm_P15.24mm_Horizontal
R10, R20: 1.00k 0.1%; R_Axial_DIN0207_L6.3mm_D2.5mm_P10.16mm_Horizontal
RV1, RV2: 500R; Potentiometer_Bourns_3296W_Vertical
TP1, TP2: GND; TestPoint_Loop_D2.50mm_Drill1.0mm
W1: 4PDT wires; Wire_Field_4PDT

Connections:
A_N: C5.1, L3.1, R11.2, R13.2, R14.1, RV2.2, RV2.3
A_P: C1.1, L1.1, R1.2, R3.2, R4.1, RV1.2, RV1.3
B_N: C6.2, C7.1, C10.2, L3.2, R15.1
B_P: C2.2, C3.1, C9.2, L1.2, R5.1
D_N: L4.1, R15.2, R16.1
D_P: L2.1, R5.2, R6.1
E_N: C8.1, L4.2, R16.2, R17.1
E_P: C4.1, L2.2, R6.2, R7.1
F_N: R17.2, W1.7, W1.8
F_P: R7.2, W1.2, W1.3
GND: C1.2, C3.2, C4.2, C5.2, C7.2, C8.2, H5.1, J3.1, J4.1, J4.G, J5.1, J5.G, R10.2, R20.2, TP1.1, TP2.1
IN_N: J2.1, J4.3, R11.1, R12.1, R13.1
IN_P: J1.1, J4.2, R1.1, R2.1, R3.1
M_N: R18.2, R19.1
M_P: R8.2, R9.1
OUT_N: J5.3, W1.6
OUT_P: J5.2, W1.1
PAD_N: R19.2, R20.1, W1.10
PAD_P: R9.2, R10.1, W1.5
PT_N: R18.1, W1.9
PT_P: R8.1, W1.4
T_N: R12.2, RV2.1
T_P: R2.2, RV1.1
X_N: C6.1, C10.1, R14.2
X_P: C2.1, C9.1, R4.2
