ToxSox/aes17_filter/(commit log)

2026-11-01 Replace the V2 tree with the reviewed and regenerated filter
    The V2 KiCad project, Gerbers, case cut-outs and spreadsheet are removed; they remain in the
    history under the tag v2-mattclark. In their place: the design review against the AUX-0025
    and the QA403, the AC simulation that produced its numbers, the sourcing list, and a board
    generated from a data file with KiCad's pcbnew - AUX-0025 values, a trimmed input network,
    a 20:1 pad on a header with a relay footprint, 4 mm and BNC connectors through the end plates
    of a Hammond 1455N1601, with Gerbers, the JLCPCB bill of materials and placement file, the
    schematic and the end-plate drilling. Licence unchanged (CERN-OHL-W 2.0); the README nam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
    [7447480102.stp, Neutrik NC3FAH2.stp, Neutrik NC3MAH-0.STEP, aes17-filter-bom.csv, aes17-filter-parts.csv, aes17-filter.kicad_pcb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]
2026-11-01 Weigh the V2 author's three planned changes against this design: shielded coils yes, 60 V goal no, SMD not for this run
    Claude-Session: https://claude.ai/code/session_017qU6JfhgmAvUk2t717G5WB
    [aes17-filter-parts.csv]
2026-11-01 Make the shielded Würth WE-TIS 7447471102 the filter's coil, sourced through JLCPCB's global sourcing
    Its ±10 % is absorbed by the trimmer and the shielding is what the V1 builders missed; JLCPCB's
    quote from four distributors is recorded, the unshielded 7447480102 stays as the fallback on the
    same, now 11.5 mm, footprint.
    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
    [aes17-filter-bom.csv, aes17-filter-parts.csv, aes17-filter.kicad_pcb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]
2026-11-01 Put the shielded coil as fitted into the trim-range and assembly tables of the design review
    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
2026-11-01 Add the bill of materials to the README, with the shielded coil's sourcing and trim range
    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
2026-11-01 Record what JLCPCB's BOM tool quoted for the filter parts
    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
2026-11-01 Give the filter the AUX-0025's connectors: female XLR and dual banana in, male XLR out, BNC pair kept for the QA403
    So one set of cables tests this filter and an AUX-0025 alike. The pad resistors move left of
    the XLR body, the output BNCs move down, the input runs on the back; the end plates get the
    Neutrik cut-outs. DRC: 0 errors, 0 unconnected.
    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
    [aes17-filter-bom.csv, aes17-filter-parts.csv, aes17-filter.kicad_pcb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]
2026-11-01 Drop the output BNCs: the filter ends in the AUX-0025's male XLR and the QA403 takes an XLR-to-two-BNC lead
    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
    [aes17-filter-bom.csv, aes17-filter-parts.csv, aes17-filter.kicad_pcb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]
2026-11-01 Give the coils their JLCPCB number C1331105 and write the BOM in plain ASCII for JLCPCB's importer
    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
    [aes17-filter-bom.csv, aes17-filter-parts.csv, aes17-filter.kicad_pcb]
2026-11-01 Place parts by their centre in the JLCPCB placement file, not by KiCad's pad-1 origin
    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
    [aes17-filter-cpl.csv]
2026-11-01 Turn the XLRs, the pad header and the trimmers in the JLCPCB placement file to match their 3D preview
    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
    [aes17-filter-cpl.csv]
2026-11-01 Turn the relay-coil header J9 a quarter in the JLCPCB placement file, as J8
    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
    [aes17-filter-cpl.csv]
2026-11-01 Put every filter connector on the front long edge, in a Hammond 1444-862 chassis
    The filter is to hang with its connectors towards the operator, as the AUX-0025's front panel
    does. The board grows to 158 x 124 mm: a 24 mm connector strip on the front edge (XLR in, red
    and black 4 mm at 19.05 mm, green common, XLR out; the toggle sits in the wall between them)
    and the unchanged filter band behind it. The box becomes the 1444-862 the original V2 named,
    because its straight walls take a connector row that a die-cast box's draft and bosses would not.
    The XLR footprints are now placed from their fabrication layers: the female's front is +x and
    the male's +y at rotation 0, which the earlier place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
    [aes17-filter.kicad_pcb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]
2026-11-01 Lay the filter board out by audio rules: whole planes, pad and switch at the output
    - Both inner layers are now uninterrupted ground planes; the two filter outputs no
    longer run on layer 3, where they cut slots under the output tracks.
    - 0.8 mm clearance throughout (IPC-2221B, bare pads, 101-300 V) instead of 0.3 mm;
    the male XLR's lands on pins 1 and 2 shrink to 3.0 mm to keep it at pin 3.
    - The two pads stand side by side behind the switch as identical copies, so their
    ratios track; the negative leg's long run forward is its 24.9 ohm output, the
    lowest impedance in the chain, instead of the output pair at 950 ohm.
    - The toggle moves high into the wall straight above K1, whose conta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
    [aes17-filter-bom.csv, aes17-filter-parts.csv, aes17-filter.kicad_pcb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]
2026-11-01 Label each of K1's contact holes for the toggle wires
    The six holes that take the pad toggle's wires now carry their own labels,
    +COM/+PAD/+DIR on the back row and -COM/-PAD/-DIR on the front, instead of one line
    of text beside them. Only the silkscreen changes; the BOM and placement files are the
    same. A placement check found no overlaps, every pad on its net, D1's cathode on
    COIL+, and the connectors facing the front wall.
    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
    [aes17-filter.kicad_pcb]
2026-11-02 Rework the filter board's silkscreen: values, signal flow, warning, crib sheet
    Top: every part's name now comes with its value in R/k/n notation (R1 1k 3W,
    R7 24R9, C3 4n7), the coils are labelled at all (their names sat on their pads
    and were clipped), the pad block has a legend under each pad, each leg carries
    its signal flow along its outer edge, a high-voltage warning sits beside the
    inputs, J9 is marked +12V, and the title reads "AES17 filter rev A" with date,
    CERN-OHL-W-2.0 and the source location. Text is 1.0 mm high (was 0.8); the
    mounting holes lose their names and the connector outlines past the front edge
    are dropped. Bottom, readable from below: pin-outs and the QA403 lead, the
    s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
    [aes17-filter.kicad_pcb]
2026-11-02 Answer an outside review: correct the rating, add a verification plan and release checks
    The rating said 85 Vrms at 20 kHz, counting only the 3 W input resistors. The Bourns
    3296 trimmer, used as a rheostat, takes sqrt(0.5 W / 500 ohm) = 31.6 mA, and that is
    reached at 56 Vrms per leg at 20 kHz and 36 Vrms at 50 kHz with the trimmer near zero;
    below 12 kHz the coils' 120 V DC operating voltage sets 85 Vrms. The rating is now a
    curve per leg to ground - 85 Vrms to 12 kHz, 53 Vrms at 20 kHz, 35 Vrms from 30 to
    100 kHz - computed by a new rating() in the simulation, and AP's 53 Vrms for the
    AUX-0025 is the same limit. A shorted output is declared a fault (the trimmer passes
    its rating from abou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
    [aes17-filter.kicad_pcb]
2026-11-02 Make the fork independent of the measurement software it was first written for
    The README, the design review, the sourcing list and the hardware notes no longer name
    or link a particular program: the software notes speak of the measurement software and
    its probe settings, and the section on what the software should do is written for
    whatever runs the QA403. The generator's own footprint library is renamed "aes17", and
    the scripts' usage lines no longer assume a directory layout. The board and the order
    files are regenerated (new source hash); BOM and placement are unchanged.
    Claude-Session: https://claude.ai/code/session_017qU6JfhgmAvU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
    [aes17-filter.kicad_pcb]
2026-11-02 Answer the second review: relay footprint, pad matching, rating above 70 kHz, coil
    - K1: the G6A footprint was Omron's bottom view drawn as a top view, so the
    polarised coil was reversed. Redrawn in top view; the + leg moves to pole
    13/11/9 and the - leg to 4/6/8 so the toggle holes keep their nets; J9 and
    D1 turned so +12 V and the diode's cathode meet coil pin 1.
    check_release.py checks the sense of rotation.
    - Pad: all three arms 0.1 % / 15 ppm (TE YR1B10KCC upper arms). The QA403
    subtracts the legs in its analogue input, so 1 % upper arms left -36 dB of
    common mode in the difference; now -52 dB.
    - R4/R14 and R6/R16 0.6 W Vishay MRS25 in the same footprint: they carry the
    st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
    [aes17-filter-bom.csv, aes17-filter-parts.csv, aes17-filter.kicad_pcb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]
2026-11-02 Switch the pad with a 4PDT toggle that takes it off the output; drop the relay
    The pad no longer hangs on the filter output in both positions. A 4PDT ON-ON
    toggle (gold contacts) has two poles per leg: pole a puts the pad's top (new
    net PT) on the filter output in PAD only, pole b picks the tap or the output
    for the XLR. In DIRECT the filter sees the analyzer alone, as on the
    AUX-0025: -0.05 dB (1.006:1) instead of -0.30 dB, and -74 dB of common mode
    in the difference at 50 Hz instead of -59 dB. PAD is unchanged (21.8:1,
    -52 dB).
    The relay footprint K1, the coil header J9 and the flyback diode D1 are gone:
    a 12 V line from an adapter or a controller would bring a second ground into
    the meas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
    [aes17-filter-bom.csv, aes17-filter-parts.csv, aes17-filter.kicad_pcb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]
2026-11-02 Remove the last traces of the relay
    The relay is gone from the board since the 4PDT toggle; this removes what was
    left of it in the text: the review table's K1 and J9 rows, the "planned relay
    matrix" and "matrix-driven attenuator" remarks, the history notes in the
    design review, sourcing list, README and schematic, the 1N4148 line in the
    JLCPCB quote table and the 1N4148 silkscreen abbreviation. The QA403's own
    attenuator relay is the instrument's and stays described.
    Board and fab files regenerated (KiCad 7.0.11): DRC 0 errors, 0 unconnected;
    check_release: fit to order.
    Claude-Session: https://claude.ai/code/session_017qU6Jgu7shLBDb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
    [aes17-filter.kicad_pcb]
2026-11-03 Leave the film capacitors out of the JLCPCB assembly; solder them by hand
    JLCPCB quoted 19 and 21 working days of pre-order for the two WIMA FKP2
    capacitors (C5742108, C20412818). They are now do-not-place: not in the BOM or
    the placement file, marked "solder by hand" in the parts list, bought locally
    (Buerklin, also as the +-1 % FKP2J002201D00ESSD; Digi-Key) and measured and
    paired between the legs before they go in. The build steps and the BOM tables
    in the docs say so.
    Claude-Session: https://claude.ai/code/session_017qU6Jgu7sh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
    [aes17-filter-bom.csv, aes17-filter-parts.csv, aes17-filter.kicad_pcb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]
2026-11-03 Leave coils, 412 R and Cliff sockets out of the JLCPCB assembly too
    Everything JLCPCB had only on pre-order is now do-not-place and bought
    locally, so the assembly waits for nothing: besides the ten film capacitors,
    the four coils, R4/R14 (412 R 0.6 W, three in stock at JLCPCB) and the Cliff
    sockets J1-J3. The coil becomes the Wurth WE-TI HV 7687480102 (V2's own part,
    +-5 %, 1.0 R, in stock at Digi-Key); the 120 V 7447480102 is the same coil.
    The remaining ten BOM lines were all in stock at JLCPCB on 3 November 2026.
    Simulation uses 1.0 R per coil; docs and build steps updated. Board and fab
    files regenerated (KiCad 7.0.11): DRC 0 errors, 0 unconnected;
    Co-Auth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
    [aes17-filter-bom.csv, aes17-filter-parts.csv, aes17-filter.kicad_pcb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]
2026-11-03 README: the assembly row says what JLCPCB fits and what is soldered by hand
    Claude-Session: https://claude.ai/code/session_017qU6Jgu7shLBDbicfdAKPL
2026-11-03 Hold the back of the board, and note switch rating, coil winding sense, trim level
    - H6 and H7: two more M3 holes in the back corners; the board hung 50 mm past the
    four holes on its centre line. Seven spacers per board now.
    - The toggle's gold contacts switch only 0.4 VA at 20 V: "switch with amp off only"
    now stands at the switch on the front wall and on the bottom silkscreen, for both
    directions, and in test 8.
    - Coil winding sense: a uniform stray field is common mode only if L1/L3 and L2/L4
    are the same way round; hardware/README.md shows how to find the winding start
    with the QA403 before soldering.
    - Trim at a few volts (bottom silkscreen, build step 5): the trim does not de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
    [aes17-filter.kicad_pcb]
2026-11-03 Answer the third review: pairing both L and C, combined rating, test 4, ground
    Documentation and simulation only; the board, the fab files and the source hash
    (ba2eb23) are unchanged.
    - cmrr(): cases for capacitors paired and for coils and capacitors paired to 1 %.
    Pairing both moves the common mode in the difference from -31 to -45 dB at
    20 kHz and -14 to -29 dB at 100 kHz; one of the two alone gains 2-4 dB. The
    build notes recommend pairing both (no longer "not required") and show how to
    do it with the QA403 when there is no LCR meter.
    - rating(): the coil figure is the WE-TI HV's 400 V; the rule for several tones at
    once (sum of (V/Vmax)^2 <= 1), with a class-D carrier example,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
2026-11-03 Record why the rev B candidates are not in rev A
    "Held over for a rev B, and why not now" under "What was not changed": shielded
    coils or a steel box, the shunt capacitors on the signal line, larger pad
    resistors - each with its reason and the test that decides it - and the toggle
    wire sorting, dropped as negligible.
    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
2026-11-03 Shopping list for the parts bought locally, with the surplus pairing needs
    hardware/README.md gets "Shopping list, bought locally (two boards)": coils, film
    capacitors, 412 R and Cliff sockets with quantities to buy and to fit, and the
    parts for pairing and the verification tests (series resistors for the QA403
    method, a 3 W reference divider for test 4, a 1 ohm shunt for test 5, optional
    WE-TIS for the comparison). 12 of each +-5 % part for 8 places: from 12 the
    chance of four pairs within 1 % is 99 % (even spread), 67 % from 10, 7 % from 8.
    docs/sourcing.md no longer says no selection is needed.
    Claude-Session: https://claude.ai/code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
2026-11-03 Plan for five assembled boards
    All five boards are assembled at JLCPCB (two for this bench, two for a
    colleague's, one spare). The ordering steps say five; the local shopping list is
    for five, paired from one pool: 24 of each +-5 % part for ten pairs (100 %
    simulated; 93 % from 22), 26 with spares; 33 of the 220 pF +-1 %, 12 of the
    412 R, 5 of each Cliff socket; box, toggle, spacers and screws five-fold, leads
    one per bench, one set of test parts. JLCPCB stock for five boards checked on
    3 November 2026 (tightest: C58750 153 for 20, C1366835 125 for 10).
    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
2026-11-03 Place the XLRs and trimmers by JLCPCB's own footprints
    JLCPCB puts the origin of its EasyEDA footprint on the placement file's
    coordinates, not the middle of KiCad's outline, so the XLRs sat up to 7 mm
    off and faced the wrong way in its preview. Rotations and origins now come
    from matching the pads of C368522, C368463 and C69564 to KiCad's. This is
    the placement file of the JLCPCB order of 3 November 2026.
    [aes17-filter-cpl.csv]
2026-11-03 Add the shopping list as ordered and the measuring instructions
    The shopping list records what was bought for the five boards: no
    enclosures yet, two toggles, three boards bridged to DIRECT. The measuring
    instructions (in German, for the apprentices) cover measuring, pairing and
    the coils' winding sense.
