ToxSox/aes17_filter/(notices)

Notices in the files:
hardware/aes17-filter.kicad_pcb:
2026-11 CERN-OHL-W-2.0
